JustinVerkade/TMC6300-Firmware/README.md

# TMC6300-Firmware
TMC6300 developement board
