JustinVerkade/TMC6300-Firmware/TMC6300-dev/MouserBom.xlsx

Name | Description | Price | Qty | Qty | Bonus | Total | Link
Core:
STM32F301C8T6TR | Microcontroller | €6.74 | 1 | 2 | 0 | €13.48 | https://nl.mouser.com/ProductDetail/STMicroelectronics/STM32F301C8T6TR?qs=qIaFMfck%2FPYy56%2F%252BEeuvMw%3D%3D
TMC6300-LA | BLDC driver | €2.27 | 1 | 2 | 0 | €4.54 | https://nl.mouser.com/ProductDetail/Trinamic/TMC6300-LA-T?qs=TiOZkKH1s2SPDan6zA6fKg%3D%3D
FT231XQ-R | USB converter | €2.34 | 1 | 2 | 0 | €4.68 | https://nl.mouser.com/ProductDetail/FTDI/FT231XQ-R?qs=Gp1Yz1mis3VkAf3iW%252BkumQ%3D%3D
TLV8541DBVR | Current opamp | €0.69 | 1 | 2 | 0 | €1.38 | https://nl.mouser.com/ProductDetail/Texas-Instruments/TLV8541DBVR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
ECS-160-7-33B-CKL-TR | 16 MHz crystal | €0.55 | 1 | 2 | 0 | €1.10 | https://nl.mouser.com/ProductDetail/ECS/ECS-160-7-33B-CKL-TR?qs=wd5RIQLrsJhEy%252BtlnvJYvQ%3D%3D
Converters:
MP1479GTF-Z | 18-4.2V DC-DC converter | €1.01 | 1 | 2 | 0 | €2.02 | https://nl.mouser.com/ProductDetail/Monolithic-Power-Systems-MPS/MP1479GTF-Z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
Inductors:
VLS3015CX-4R7M-1 | DC-DC inductor | €0.38 | 1 | 2 | 0 | €0.76 | https://nl.mouser.com/ProductDetail/TDK/VLS3015CX-4R7M-1?qs=gZXFycFWdANzf31QH9GBWA%3D%3D
MMZ1005A102ETD25 | Ferrite bead 1000 Ohm | €0.19 | 1 | 3 | 1 | €0.57 | https://nl.mouser.com/ProductDetail/TDK/MMZ1005A102ETD25?qs=pvNC7ksEVIeZfzV4kcHyXA%3D%3D
MMZ1005S121CT000 | Ferrite bead 120 Ohm | €0.10 | 1 | 3 | 1 | €0.30 | https://nl.mouser.com/ProductDetail/TDK/MMZ1005S121CT000?qs=pLY5GE0xrmKkPI5sI3d9Jg%3D%3D
LEDS:
150060AS75000 | Amber LED | €0.15 | 4 | 10 | 2 | €1.51 | https://nl.mouser.com/ProductDetail/Wurth-Elektronik/150060AS75000?qs=d0WKAl%252BL4KbvMBYryeof0Q%3D%3D
Interfaces:
TB006-508-02BE | 2 pin screw terminal | €0.85 | 1 | 2 | 0 | €1.70 | https://nl.mouser.com/ProductDetail/CUI-Devices/TB006-508-02BE?qs=vLWxofP3U2wEdOVV%2FaT04w%3D%3D
TB006-508-03BE | 3 pin screw terminal | €0.81 | 1 | 2 | 0 | €1.62 | https://nl.mouser.com/ProductDetail/CUI-Devices/TB006-508-03BE?qs=vLWxofP3U2zmvvLYJBQLMA%3D%3D
1-1734035-1 | USB connector | €1.85 | 1 | 2 | 0 | €3.70 | https://nl.mouser.com/ProductDetail/TE-Connectivity/1-1734035-1?qs=x6EjVpvqMVOdSE4jVN5kww%3D%3D
5-146280-3 | 3 pin ADC headers | €0.59 | 4 | 8 | 0 | €4.72 | https://nl.mouser.com/ProductDetail/TE-Connectivity/5-146280-3?qs=bwpFY26eRVf7xnwkMZzVxA%3D%3D
5-146280-6 | 6 pin GPIO + PGRM headers | €1.17 | 2 | 4 | 0 | €4.68 | https://nl.mouser.com/ProductDetail/TE-Connectivity/5-146280-6?qs=bwpFY26eRVeUvO%252BsrBd9wQ%3D%3D
Capacitors:
GRM21BR61C106KE15K | 0805 10uF 16V | €0.17 | 1 | 3 | 1 | €0.51 | https://nl.mouser.com/ProductDetail/Murata-Electronics/GRM21BR61C106KE15K?qs=h0WOCFF19ULjTOS37upAEw%3D%3D
CGA3E1X7R1E105K080AC | 0603 1uF 25V | €0.07 | 6 | 14 | 2 | €1.05 | https://nl.mouser.com/ProductDetail/TDK/CGA3E1X7R1E105K080AC?qs=NRhsANhppD9VxGl2AsmRpw%3D%3D
C1005X7R1C104K050BC | 0402 100nF 16V | €0.04 | 19 | 41 | 3 | €1.48 | https://nl.mouser.com/ProductDetail/TDK/C1005X7R1C104K050BC?qs=NRhsANhppD%252BhAGOapA8QKQ%3D%3D
C1005X7R1C103K050BA | 0402 10nF 16V | €0.10 | 1 | 3 | 1 | €0.30 | https://nl.mouser.com/ProductDetail/TDK/C1005X7R1C103K050BA?qs=NRhsANhppD%252Bt7xPr32kpQA%3D%3D
04026A100JAT2A | 0402 10pF 6.3V | €0.27 | 2 | 6 | 2 | €1.62 | https://nl.mouser.com/ProductDetail/KYOCERA-AVX/04026A100JAT2A?qs=XLNwXgtzMM%2Fx5CgSRtM7uA%3D%3D
CGA2B2NP01H470J050BA | 0402 47pF 50V | €0.11 | 2 | 6 | 2 | €0.66 | https://nl.mouser.com/ProductDetail/TDK/CGA2B2NP01H470J050BA?qs=6JAMGB%252BEdkw5NUtjDhoWqw%3D%3D
CGB3B3X5R0J475M055AB | 0603 4.7uF 6.3V | €0.23 | 1 | 3 | 1 | €0.69 | https://nl.mouser.com/ProductDetail/TDK/CGB3B3X5R0J475M055AB?qs=iuKcRwBk4Q%252BgDidcFgkVCg%3D%3D
885012106004 | 0603 2.2uF 6.3V | €0.18 | 1 | 3 | 1 | €0.54 | https://nl.mouser.com/ProductDetail/Wurth-Elektronik/885012106004?qs=0KOYDY2FL29xXNGAslaR%252BA%3D%3D
GRM21BC81C226ME44L | 0805 22uF 16V | €0.36 | 2 | 6 | 2 | €2.16 | https://nl.mouser.com/ProductDetail/Murata-Electronics/GRM21BC81C226ME44L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
Resistors:
ERJ-8BSFR15V | 1206 150mOhm Current sense resistor | €0.69 | 2 | 6 | 2 | €4.14 | https://nl.mouser.com/ProductDetail/Panasonic/ERJ-8BSFR15V?qs=e5m3IbTHPW9lW7phmk%2F0Ow%3D%3D
ESR01MZPJ270 | 0402 27Ohm | €0.26 | 2 | 6 | 2 | €1.56 | https://nl.mouser.com/ProductDetail/ROHM-Semiconductor/ESR01MZPJ270?qs=MyNHzdoqoQIa590aWb6Exg%3D%3D
RT0402FRD0710KL | 0402 10KOhm | €0.15 | 2 | 6 | 2 | €0.90 | https://nl.mouser.com/ProductDetail/YAGEO/RT0402FRD0710KL?qs=9h0bZHM%2F3zLluUCJgNukFQ%3D%3D
RC0402DR-072K52L | 0402 2.52KOhm | €0.21 | 1 | 4 | 2 | €0.84 | https://nl.mouser.com/ProductDetail/YAGEO/RC0402DR-072K52L?qs=1X5yxNMcnLwNaDe6eJizmQ%3D%3D
AC0402FR-07649RL | RC0402FR-07649RL | €0.01 | 4 | 10 | 2 | €0.14 | https://nl.mouser.com/ProductDetail/YAGEO/RC0402FR-07649RL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
ERJ-U02F10R0X | 0402 10Ohm | €0.12 | 1 | 4 | 2 | €0.48 | https://nl.mouser.com/ProductDetail/Panasonic/ERJ-U02F10R0X?qs=bKFmlxG1yYBDa1TMm2jpJg%3D%3D
RT0402FRE131KL | 0402 1KOhm | €0.10 | 2 | 6 | 2 | €0.60 | https://nl.mouser.com/ProductDetail/YAGEO/RT0402FRE131KL?qs=sGAEpiMZZMtlubZbdhIBIKX7RhrzB5EA31c5dfXFDbo%3D
AC0402FR-072K2L | 0402 2.2KOhm | €0.10 | 3 | 8 | 2 | €0.80 | https://nl.mouser.com/ProductDetail/YAGEO/AC0402FR-072K2L?qs=sGAEpiMZZMtlubZbdhIBINBo7nw4llFtUfPpyF548pk%3D
RC0402JR-7D100KL | 0402 100KOhm | €0.01 | 7 | 17 | 3 | €0.24 | https://nl.mouser.com/ProductDetail/YAGEO/RC0402JR-7D100KL?qs=F5EMLAvA7IBECWZ2NRPfcA%3D%3D
AC0402FR-0747RL | 0402 47Ohm | €0.10 | 1 | 3 | 1 | €0.30 | https://nl.mouser.com/ProductDetail/YAGEO/AC0402FR-0747RL?qs=sGAEpiMZZMtlubZbdhIBINBo7nw4llFtmj2sOisr1bg%3D
AC0402JR-0713KL | 0402 13KOhm | €0.10 | 1 | 3 | 1 | €0.30 | https://nl.mouser.com/ProductDetail/YAGEO/AC0402JR-0713KL?qs=sGAEpiMZZMtlubZbdhIBIGSQoKF9BUrRRASCQsvRSGs%3D
CR0402-FX-4022GLF | 0402 40.2KOhm | €0.10 | 1 | 3 | 1 | €0.30 | https://nl.mouser.com/ProductDetail/Bourns/CR0402-FX-4022GLF
AC0402FR-1347KL | 0402 47KOhm | €0.10 | 1 | 3 | 1 | €0.30 | https://nl.mouser.com/ProductDetail/YAGEO/AC0402FR-1347KL?qs=pfd5qewlna53%252BjKDsnke9A%3D%3D
RC0402FR-075KL | 0402 5KOhm | €0.01 | 4 | 10 | 2 | €0.12 | https://nl.mouser.com/ProductDetail/YAGEO/RC0402FR-075KL?qs=9h0bZHM%2F3zL5adZvfm%252BR4Q%3D%3D
 |  | Parts | 89 | 222 | Total | €66.784
