JustinVerkade/TMC6300-Firmware/TMC6300-dev/TMC6300-dev.kicad_pcb

## KiCad design TMC6300-dev/TMC6300-dev.kicad_pcb (2024-11-14)

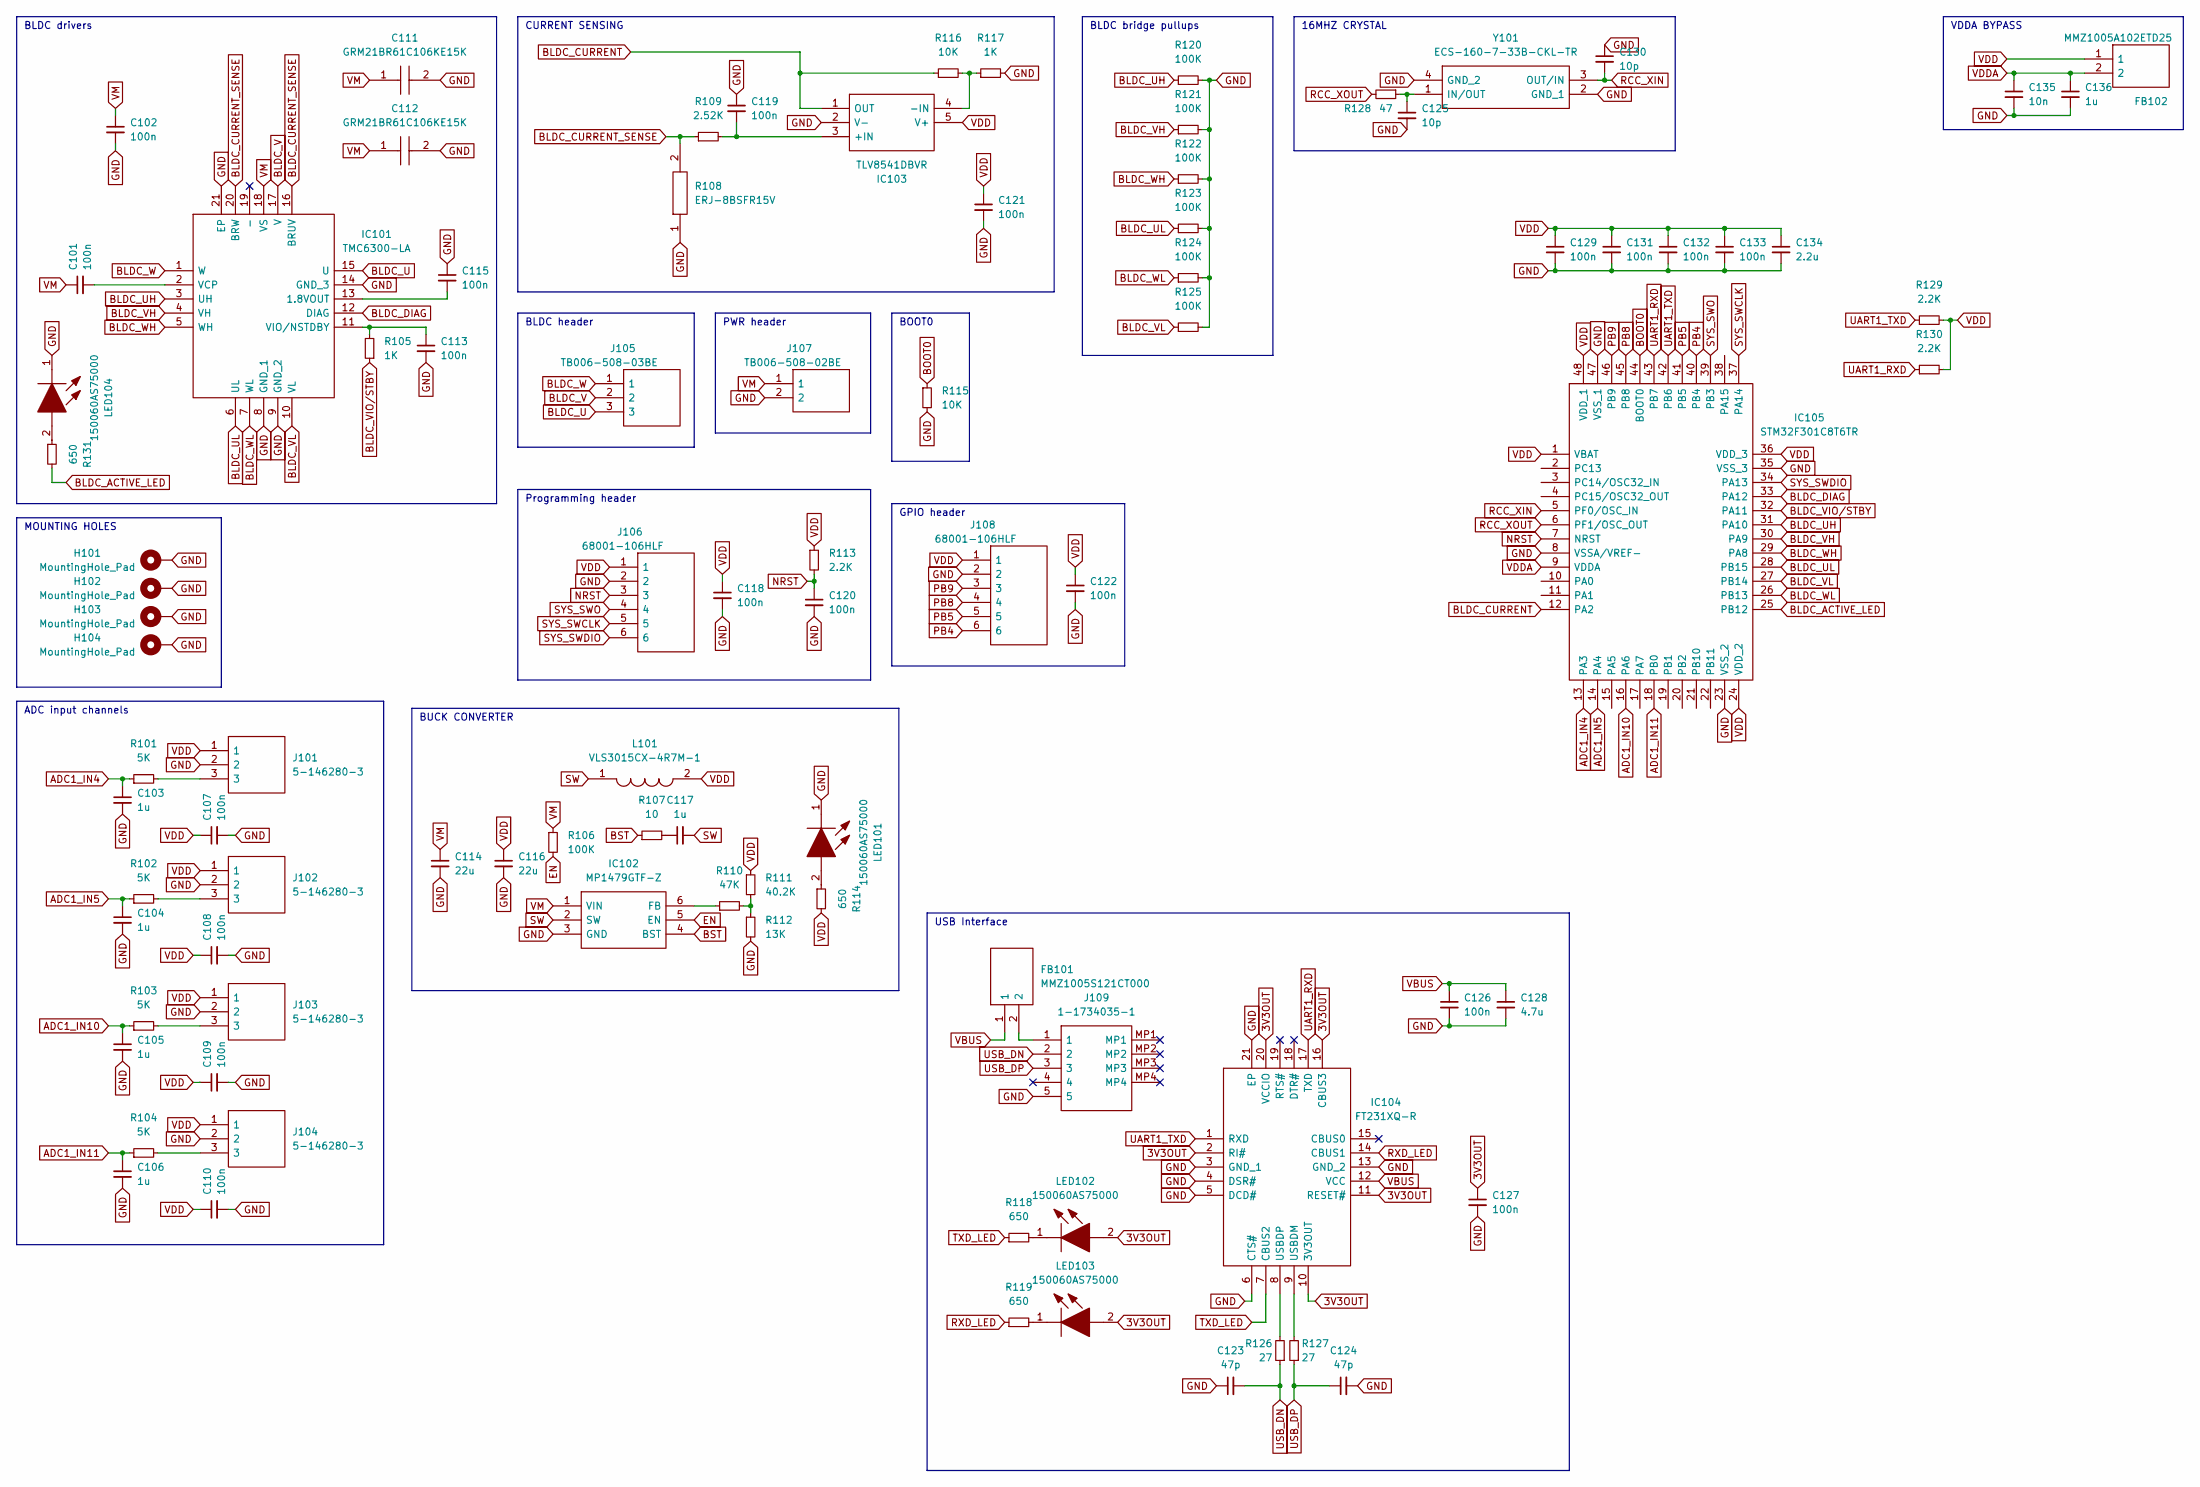
[picture p1: schematic TMC6300-dev.kicad_sch]

Parts:
C101, C102, C107, C108, C109, C110, C113, C115, C118, C119, C120, C121, C122, C126, C127, C129, C131, C132, C133: 100n; C_0402_1005Metric
C103, C104, C105, C106, C117, C136: 1u; C_0603_1608Metric
C111, C112: GRM21BR61C106KE15K; CAPC2012X135N; Mouser Part Number 81-GRM21BR61C106KE5K
C114, C116: 22u; C_0805_2012Metric
C123, C124: 47p; C_0402_1005Metric
C125, C130: 10p; C_0402_1005Metric
C128: 4.7u; C_0603_1608Metric
C134: 2.2u; C_0603_1608Metric
C135: 10n; C_0402_1005Metric
FB101: MMZ1005S121CT000; BEADC1005X55N; Mouser Part Number 810-MMZ1005S121CT000
FB102: MMZ1005A102ETD25; BEADC1005X55N; Mouser Part Number 810-MMZ1005A102ETD25
H101, H102, H103, H104: MountingHole_Pad; MountingHole_3.2mm_M3_Pad_Via
IC101: TMC6300-LA; QFN40P300X300X90-21N; Mouser Part Number 700-TMC6300-LA
IC102: MP1479GTF-Z; MP1479GTFZ; Mouser Part Number 946-MP1479GTF-Z
IC103: TLV8541DBVR; SOT95P280X145-5N; Mouser Part Number 595-TLV8541DBVR
IC104: FT231XQ-R; QFN50P400X400X80-21N; Mouser Part Number 895-FT231XQ-R
IC105: STM32F301C8T6TR; QFP50P900X900X160-48N; Mouser Part Number 511-STM32F301C8T6TR
J101, J102, J103, J104: 5-146280-3; HDRV3W97P0X254_1X3_721X234X821P; Mouser Part Number 571-5-146280-3
J105: TB006-508-03BE; TB00650803BE; Mouser Part Number 490-TB006-508-03BE
J106, J108: 68001-106HLF; HDRV6W67P0X254_1X6_1524X241X834P; Mouser Part Number 649-68001-106HLF
J107: TB006-508-02BE; TB00650802BE; Mouser Part Number 490-TB006-508-02BE
J109: 1-1734035-1; 117340351; Mouser Part Number 571-1-1734035-1
L101: VLS3015CX-4R7M-1; VLS3015; Manufacturer_Part_Number VLS3015CX-4R7M-1; Mouser Part Number 810-VLS3015CX-4R7M-1
LED101, LED102, LED103, LED104: 150060AS75000; LEDC1608X80N; Mouser Part Number 710-150060AS75000
R101, R102, R103, R104: 5K; R_0402_1005Metric
R105, R117: 1K; R_0402_1005Metric
R106, R120, R121, R122, R123, R124, R125: 100K; R_0402_1005Metric
R107: 10; R_0402_1005Metric
R108: ERJ-8BSFR15V; ERJ8_B_BW_R_LW_CW_D; Mouser Part Number 667-ERJ-8BSFR15V
R109: 2.52K; R_0402_1005Metric
R110: 47K; R_0402_1005Metric
R111: 40.2K; R_0402_1005Metric
R112: 13K; R_0402_1005Metric
R113, R129, R130: 2.2K; R_0402_1005Metric
R114, R118, R119, R131: 650; R_0402_1005Metric
R115, R116: 10K; R_0402_1005Metric
R126, R127: 27; R_0402_1005Metric
R128: 47; R_0402_1005Metric
Y101: ECS-160-7-33B-CKL-TR; ECS160733BCKLTR; Manufacturer_Part_Number ECS-160-7-33B-CKL-TR

Connections:
3V3OUT: C127.1, IC104.2 (RI#), IC104.10 (3V3OUT), IC104.11 (RESET#), IC104.16 (CBUS3), IC104.20 (VCCIO), LED102.2, LED103.2
ADC1_IN4: C103.1, IC105.13 (PA3), R101.1
ADC1_IN5: C104.1, IC105.14 (PA4), R102.1
ADC1_IN10: C105.1, IC105.16 (PA6), R103.1
ADC1_IN11: C106.1, IC105.18 (PB0), R104.1
BLDC_ACTIVE_LED: IC105.25 (PB12), R131.2
BLDC_CURRENT: IC103.1 (OUT), IC105.12 (PA2), R116.1
BLDC_CURRENT_SENSE: IC101.16 (BRUV), IC101.20 (BRW), R108.2, R109.1
BLDC_DIAG: IC101.12 (DIAG), IC105.33 (PA12)
BLDC_U: IC101.15 (U), J105.3
BLDC_UH: IC101.3 (UH), IC105.31 (PA10), R120.1
BLDC_UL: IC101.6 (UL), IC105.28 (PB15), R123.1
BLDC_V: IC101.17 (V), J105.2
BLDC_VH: IC101.4 (VH), IC105.30 (PA9), R121.1
BLDC_VIO/STBY: IC105.32 (PA11), R105.1
BLDC_VL: IC101.10 (VL), IC105.27 (PB14), R125.1
BLDC_W: IC101.1 (W), J105.1
BLDC_WH: IC101.5 (WH), IC105.29 (PA8), R122.1
BLDC_WL: IC101.7 (WL), IC105.26 (PB13), R124.1
BOOT0: IC105.44 (BOOT0), R115.1
BST: IC102.4 (BST), R107.1
EN: IC102.5 (EN), R106.2
GND: C102.2, C103.2, C104.2, C105.2, C106.2, C107.2, C108.2, C109.2, C110.2, C111.2, C112.2, C113.2, C114.2, C115.1, C116.2, C118.2, C119.1, C120.2, C121.2, C122.2, C123.1, C124.2, C125.2, C126.2, C127.2, C128.2, C129.2, C130.1, C131.2, C132.2, C133.2, C134.2, C135.2, C136.2, H101.1, H102.1, H103.1, H104.1, IC101.8 (GND_1), IC101.9 (GND_2), IC101.14 (GND_3), IC101.21 (EP), IC102.3 (GND), IC103.2 (V-), IC104.3 (GND_1), IC104.4 (DSR#), IC104.5 (DCD#), IC104.6 (CTS#), IC104.13 (GND_2), IC104.21 (EP), IC105.8 (VSSA/VREF-), IC105.23 (VSS_2), IC105.35 (VSS_3), IC105.47 (VSS_1), J101.2, J102.2, J103.2, J104.2, J106.2, J107.2, J108.2, J109.5, LED101.1, LED104.1, R108.1, R112.2, R115.2, R117.2, R120.2, R121.2, R122.2, R123.2, R124.2, R125.2, Y101.2 (GND_1), Y101.4 (GND_2)
NRST: C120.1, IC105.7 (NRST), J106.3, R113.2
unnamed: C101.2, IC101.2 (VCP)
unnamed: C113.1, IC101.11 (VIO/NSTDBY), R105.2
unnamed: C115.2, IC101.13 (1.8VOUT)
unnamed: C117.1, R107.2
unnamed: C119.2, IC103.3 (+IN), R109.2
unnamed: C125.1, R128.1, Y101.1 (IN/OUT)
unnamed: FB101.2, J109.1
unnamed: IC102.6 (FB), R110.1
unnamed: IC103.4 (-IN), R116.2, R117.1
unnamed: IC104.8 (USBDP), R126.2
unnamed: IC104.9 (USBDM), R127.2
unnamed: J101.3, R101.2
unnamed: J102.3, R102.2
unnamed: J103.3, R103.2
unnamed: J104.3, R104.2
unnamed: LED101.2, R114.1
unnamed: LED102.1, R118.2
unnamed: LED103.1, R119.2
unnamed: LED104.2, R131.1
unnamed: R110.2, R111.2, R112.1
PB4: IC105.40 (PB4), J108.6
PB5: IC105.41 (PB5), J108.5
PB8: IC105.45 (PB8), J108.4
PB9: IC105.46 (PB9), J108.3
RCC_XIN: C130.2, IC105.5 (PF0/OSC_IN), Y101.3 (OUT/IN)
RCC_XOUT: IC105.6 (PF1/OSC_OUT), R128.2
RXD_LED: IC104.14 (CBUS1), R119.1
SW: C117.2, IC102.2 (SW), L101.1
SYS_SWCLK: IC105.37 (PA14), J106.5
SYS_SWDIO: IC105.34 (PA13), J106.6
SYS_SWO: IC105.39 (PB3), J106.4
TXD_LED: IC104.7 (CBUS2), R118.1
UART1_RXD: IC104.17 (TXD), IC105.43 (PB7), R130.1
UART1_TXD: IC104.1 (RXD), IC105.42 (PB6), R129.1
USB_DN: C123.2, J109.2, R126.1
USB_DP: C124.1, J109.3, R127.1
VBUS: C126.1, C128.1, FB101.1, IC104.12 (VCC)
VDD: C107.1, C108.1, C109.1, C110.1, C116.1, C118.1, C121.1, C122.1, C129.1, C131.1, C132.1, C133.1, C134.1, FB102.1, IC103.5 (V+), IC105.1 (VBAT), IC105.24 (VDD_2), IC105.36 (VDD_3), IC105.48 (VDD_1), J101.1, J102.1, J103.1, J104.1, J106.1, J108.1, L101.2, R111.1, R113.1, R114.2, R129.2, R130.2
VDDA: C135.1, C136.1, FB102.2, IC105.9 (VDDA)
VM: C101.1, C102.1, C111.1, C112.1, C114.1, IC101.18 (VS), IC102.1 (VIN), J107.1, R106.1

Notes on the sheet:
BLDC header
PWR header
BLDC bridge pullups
Programming header
GPIO header
BOOT0
ADC input channels
16MHZ CRYSTAL
CURRENT SENSING
BUCK CONVERTER
BLDC drivers
VDDA BYPASS
MOUNTING HOLES
USB Interface

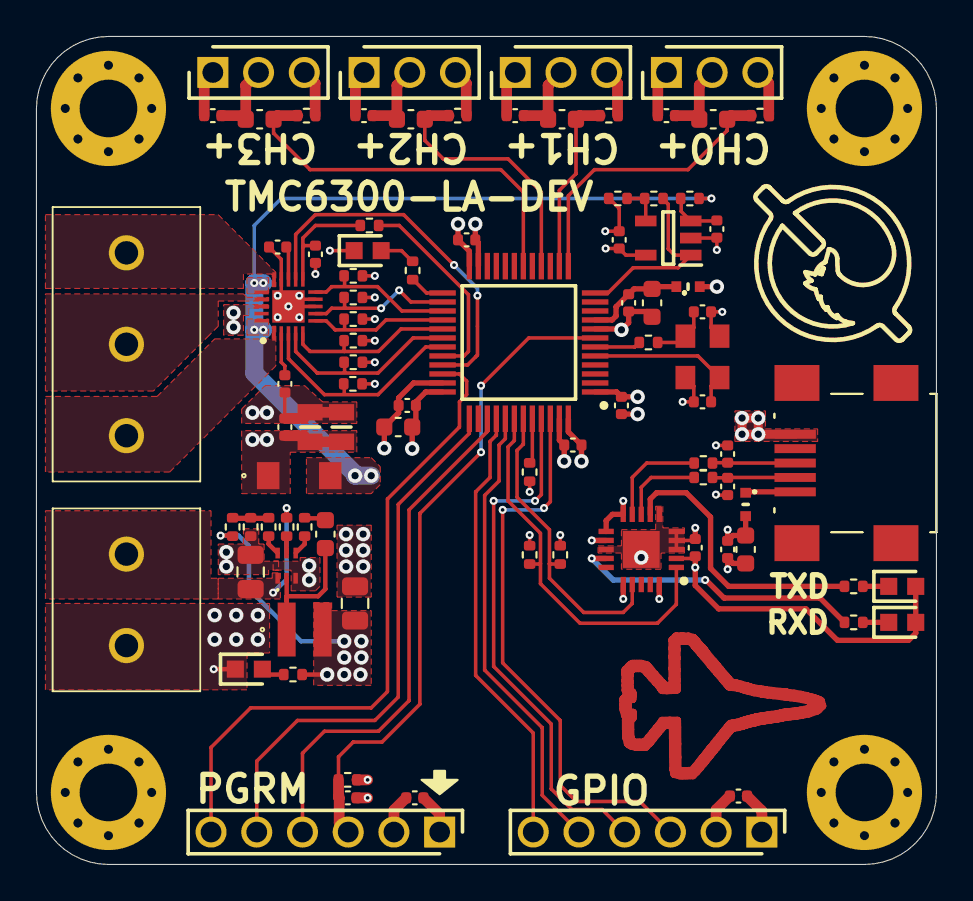
[picture p2: board TMC6300-dev.kicad_pcb from above]

Board: 4 copper layers, 50.0 x 46.0 mm, 93 parts (0 on the bottom side), 64 nets.
