JustinVerkade/TMC6300-Firmware/Core/Src/main.c

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
/* Includes ------------------------------------------------------------------*/
#include "main.h"

/* USER CODE BEGIN Includes */
#include "TMC6300.h"
#include <stdlib.h>
#include <string.h>
#include <stdio.h>

/* USER CODE END Includes */

ADC_HandleTypeDef hadc1;
DMA_HandleTypeDef hdma_adc1;

TIM_HandleTypeDef htim1;

UART_HandleTypeDef huart3;

/* USER CODE BEGIN PV */
TMC6300_t bldc;
uint32_t adc_dma_buffer[5];
/* USER CODE END PV */

void SystemClock_Config(void);
static void MX_GPIO_Init(void);
static void MX_DMA_Init(void);
static void MX_ADC1_Init(void);
static void MX_TIM1_Init(void);
static void MX_USART3_UART_Init(void);
/* USER CODE BEGIN 0 */

// diag interrupt callback
void HAL_GPIO_EXTI_Callback(uint16_t GPIO_Pin)
{
	// diagnostics callback
	TMC6300_DiagCallback(&bldc, GPIO_Pin);
}

/* USER CODE END 0 */

/**
  * @brief  The application entry point.
  * @retval int
  */
int main(void)
{
  /* MCU Configuration--------------------------------------------------------*/

  /* Reset of all peripherals, Initializes the Flash interface and the Systick. */
  HAL_Init();

  /* Configure the system clock */
  SystemClock_Config();

  /* Initialize all configured peripherals */
  MX_GPIO_Init();
  MX_DMA_Init();
  MX_ADC1_Init();
  MX_TIM1_Init();
  MX_USART3_UART_Init();
  /* USER CODE BEGIN 2 */

	HAL_Delay(500);

	// bldc init
	TMC6300_Init(&bldc,
			&htim1,
			TIM_CHANNEL_1,
			TIM_CHANNEL_2,
			TIM_CHANNEL_3,
			BLDC_VIO_STBY_GPIO_Port,
			BLDC_VIO_STBY_Pin,
			BLDC_DIAG_GPIO_Port,
			BLDC_DIAG_Pin);

	TMC6300_Enable(&bldc);

	HAL_Delay(100);

	uint16_t power = 25;
	for(; power<2000; power++)
	{
		TMC6300_SetPhaseAngle(&bldc, 0, power);
		if(HAL_GPIO_ReadPin(BLDC_DIAG_GPIO_Port, BLDC_DIAG_Pin))
		{
			HAL_GPIO_WritePin(BLDC_ACTIVE_LED_GPIO_Port, BLDC_ACTIVE_LED_Pin, GPIO_PIN_SET);
			break;
		}
		HAL_Delay(500);
	}

	power -= 10;
	TMC6300_SetPhaseAngle(&bldc, 0, power);

	// reset
	TMC6300_Disable(&bldc);
	HAL_Delay(1000);
	TMC6300_Enable(&bldc);
	HAL_Delay(200);
	HAL_GPIO_WritePin(BLDC_ACTIVE_LED_GPIO_Port, BLDC_ACTIVE_LED_Pin, GPIO_PIN_RESET);

	for(; power<200; power++)
	{
		TMC6300_SetPhaseAngle(&bldc, 0, power);
		if(HAL_GPIO_ReadPin(BLDC_DIAG_GPIO_Port, BLDC_DIAG_Pin))
		{
			HAL_GPIO_WritePin(BLDC_ACTIVE_LED_GPIO_Port, BLDC_ACTIVE_LED_Pin, GPIO_PIN_SET);
			break;
		}
		HAL_Delay(400);
	}

	power -= 20;
	TMC6300_SetPhaseAngle(&bldc, 0, power);

	// reset
	TMC6300_Disable(&bldc);
	HAL_Delay(1000);
	TMC6300_Enable(&bldc);
	HAL_Delay(400);
	HAL_GPIO_WritePin(BLDC_ACTIVE_LED_GPIO_Port, BLDC_ACTIVE_LED_Pin, GPIO_PIN_RESET);

	uint32_t arcsecond = 0;

  /* USER CODE END 2 */

  /* Infinite loop */
  /* USER CODE BEGIN WHILE */
	while (1)
	{
		TMC6300_SetPhaseAngle(&bldc, arcsecond, power);
		arcsecond += 450;
		for(uint32_t i=0; i<125; i++);

//		if(HAL_GPIO_ReadPin(BLDC_DIAG_GPIO_Port, BLDC_DIAG_Pin))
//			HAL_GPIO_WritePin(BLDC_ACTIVE_LED_GPIO_Port, BLDC_ACTIVE_LED_Pin, GPIO_PIN_SET);

    /* USER CODE END WHILE */

    /* USER CODE BEGIN 3 */
	}
  /* USER CODE END 3 */
}

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
