JustinVerkade/TMC6300-Firmware/TMC6300-dev.ioc

Mcu.UserName=STM32F301C8Tx
PA10.GPIO_Label=BLDC_UH
PA10.Signal=S_TIM1_CH3
PA11.GPIO_Label=BLDC_VIO_STBY
PA11.Signal=GPIO_Output
PA12.GPIO_Label=BLDC_DIAG
PA12.Signal=GPIO_Input
PA13.Signal=SYS_JTMS-SWDIO
PA14.Signal=SYS_JTCK-SWCLK
PA2.GPIO_Label=BLDC_CURRENT
PA2.Signal=ADC1_IN3
PA3.Signal=ADC1_IN4
PA4.Signal=ADC1_IN5
PA6.Signal=ADCx_IN10
PA8.GPIO_Label=BLDC_WH
PA8.Signal=GPIO_Output
PA9.GPIO_Label=BLDC_VH
PA9.Signal=GPIO_Output
PB0.Signal=ADC1_IN11
PB12.GPIO_Label=BLDC_ACTIVE_LED
PB12.Signal=GPIO_Output
PB13.GPIO_Label=BLDC_WL
PB13.Signal=GPIO_Output
PB14.GPIO_Label=BLDC_VL
PB14.Signal=GPIO_Output
PB15.GPIO_Label=BLDC_UL
PB15.Signal=TIM1_CH3N
PB3.Signal=SYS_JTDO-TRACESWO
PB4.Signal=GPIO_Output
PB5.Signal=GPIO_Output
PB8.Signal=USART3_RX
PB9.Signal=USART3_TX
PF0-OSC_IN.Signal=RCC_OSC_IN
PF1-OSC_OUT.Signal=RCC_OSC_OUT
