JustinVerkade/TMC6300-Firmware/Core/Inc/main.h

#define BLDC_CURRENT_Pin GPIO_PIN_2
#define BLDC_CURRENT_GPIO_Port GPIOA
#define BLDC_ACTIVE_LED_Pin GPIO_PIN_12
#define BLDC_ACTIVE_LED_GPIO_Port GPIOB
#define BLDC_WL_Pin GPIO_PIN_13
#define BLDC_WL_GPIO_Port GPIOB
#define BLDC_VL_Pin GPIO_PIN_14
#define BLDC_VL_GPIO_Port GPIOB
#define BLDC_UL_Pin GPIO_PIN_15
#define BLDC_UL_GPIO_Port GPIOB
#define BLDC_WH_Pin GPIO_PIN_8
#define BLDC_WH_GPIO_Port GPIOA
#define BLDC_VH_Pin GPIO_PIN_9
#define BLDC_VH_GPIO_Port GPIOA
#define BLDC_UH_Pin GPIO_PIN_10
#define BLDC_UH_GPIO_Port GPIOA
#define BLDC_VIO_STBY_Pin GPIO_PIN_11
#define BLDC_VIO_STBY_GPIO_Port GPIOA
#define BLDC_DIAG_Pin GPIO_PIN_12
#define BLDC_DIAG_GPIO_Port GPIOA
