JustinVerkade/TMC6300-Firmware/Core/Inc/TMC6300_commutation_table.h

/*
 * TMC6300_commutation_table.h
 *
 *  Created on: 28 jun. 2023
 *      Author: J.Verkade
 */

#ifndef INC_TMC6300_COMMUTATION_TABLE_H_
#define INC_TMC6300_COMMUTATION_TABLE_H_

static const int16_t array[] = {1024,1026,1028,1031,1033,1035,1037,1040,1042,1044,1046,1049,1051,1053,1055,1058,1060,1062,1064,1066,1069,1071,1073,1075,1078,1080,1082,1084,1087,1089,1091,1093,1095,1098,1100,1102,1104,1107,1109,1111,1113,1115,1118,1120,1122,1124,1127,1129,1131,1133,1135,1138,1140,1142,1144,1147,1149,1151,1153,1155,1158,1160,1162,1164,1167,1169,1171,1173,1175,1178,1180,1182,1184,1186,1189,1191,1193,1195,1197,1200,1202,1204,1206,1208,1211,1213,1215,1217,1219,1222,1224,1226,1228,1230,1233,1235,1237,1239,1241,1243,1246,1248,1250,1252,1254,1257,1259,1261,1263,1265,1267,1270,1272,1274,1276,1278,1280,1283,1285,1287,1289,1291,1293,1295,1298,1300,1302,1304,1306,1308,1311,1313,1315,1317,1319,1321,1323,1326,1328,1330,1332,1334,1336,1338,1340,1343,1345,1347,1349,1351,1353,1355,1357,1359,1362,1364,1366,1368,1370,1372,1374,1376,1378,1381,1383,1385,1387,1389,1391,1393,1395,1397,1399,1401,1403,1406,1408,1410,1412,1414,1416,1418,1420,1422,1424,1426,1428,1430,1432,1434,1436,1438,1440,1443,1445,1447,1449,1451,1453,1455,1457,1459,1461,1463,1465,1467,1469,1471,1473,1475,1477,1479,1481,1483,1485,1487,1489,1491,1493,1495,1497,1499,1501,1503,1505,1507,1509,1511,1513,1515,1517,1518,1520,1522,1524,1526,1528,1530,1532,1534,1536,1538,1540,1542,1544,1546,1548,1549,1551,1553,1555,1557,1559,1561,1563,1565,1567,1569,1570,1572,1574,1576,1578,1580,1582,1584,1585,1587,1589,1591,1593,1595,1597,1598,1600,1602,1604,1606,1608,1610,1611,1613,1615,1617,1619,1620,1622,1624,1626,1628,1630,1631,1633,163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
63,765,768,770,772,774,776,778,781,783,785,787,789,791,794,796,798,800,802,805,807,809,811,813,815,818,820,822,824,826,829,831,833,835,837,840,842,844,846,848,851,853,855,857,859,862,864,866,868,870,873,875,877,879,881,884,886,888,890,893,895,897,899,901,904,906,908,910,913,915,917,919,921,924,926,928,930,933,935,937,939,941,944,946,948,950,953,955,957,959,961,964,966,968,970,973,975,977,979,982,984,986,988,990,993,995,997,999,1002,1004,1006,1008,1011,1013,1015,1017,1020,1022};

#endif /* INC_TMC6300_COMMUTATION_TABLE_H_ */
