JustinVerkade/TMC6300-Firmware/(commit log)

2024-03-12 Added hardware files
    [BlankBOM.xlsx, MouserBom.xlsx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]
2024-11-14 Push to Github for cleanup
    [TMC6300-dev-B_Cu.gbr, TMC6300-dev-B_Mask.gbr, TMC6300-dev-B_Paste.gbr, TMC6300-dev-B_Silkscreen.gbr, TMC6300-dev-Edge_Cuts.gbr, TMC6300-dev-F_Cu.gbr, TMC6300-dev-F_Mask.gbr, TMC6300-dev-F_Paste.gbr]
